Matei2010/CrazyCar_Prototype_-IN_DEVELOPMENT-/BOM (version 1).xlsx

Reference | Value | Datasheet | Footprint | Qty | DISTRIBUTOR | MANUFACTURER | ORDER_NO | PART_NO | Beschreibung | PRICE_UNIT | CATEGORY | Full price (exkl Tax and Shipping) | shipping
BT1 | 8.4V |  |  | 1 | Rotorama | CNHL |  | https://www.rotorama.de/product/cnhl-ministar-hv-450mah-2s-70c | CNHL Ministar HV 450mAh 2S 70C | 5.99 |  | 5.99 | LCSC | "=" | 32.14 |  | (Global standard directline is about 20€ cheaper, but Requires a 50€ tarriffhold which brings it up to about 90€. i dont know if i will get it back, so better to be sure than sorry
BZ1 | Buzzer |  | Buzzer_Beeper:Buzzer_12x9.5RM7.6 | 5 | LCSC | XHXDZ | C49246932 | TMB12A12 | Buzzer, polarized | 0.19 |  | 0.942 | Aliexpress | "=" | 12 € | Free "Choice Shipping" but i have to pay 12€ in tarrifs to austria
C1,C2,C4,C5,C7,C8,C9,C12,C14,C15,C16,C19,C20 | 100n |  | Capacitor_SMD:C_0805_2012Metric | 20 | LCSC | YAGEO | C49678 | CC0805KRX7R9BB104 | Unpolarized capacitor | 0.19 |  | 3.8 | Rotorama | "=" | 5.58
C3 | 470uF |  | Capacitor_THT:CP_Radial_D8.0mm_P3.50mm | 1 | LCSC | KNSCHA | C2831775 | 03EC0575 |  | 0.04 |  | 0.0415
C6 | 10n |  | Capacitor_SMD:C_0805_2012Metric | 100 | LCSC | CCTC | C282728 | TCC0805X7R103K500DT | Unpolarized capacitor | 0.01 |  | 0.61
C11,C13,C17,C18,C21,C22 | 10u |  | Capacitor_SMD:C_0805_2012Metric | 6 | LCSC | muRata | C440198 | GRM21BR61H106KE43L | Unpolarized capacitor | 0.18 |  | 1.092
D1,D2 | LED |  | LED_SMD:LED_0805_2012Metric | 100 | LCSC | XINGLIGHT | C965799 | XL-1608SURC-06 | Light emitting diode | 0.01 |  | 1
IC1,IC2 | RZ7889 | http://www.rz-mic.com/uploadfile/fj/2011122615211.pdf | RZ7889:SOIC127P600X175-8N | 2 | LCSC | MSKSEMI | C22462543 | RZ7889-MS | SOP-8 3A Single-CH DC Motor Driver Circuit | 0.43 |  | 0.8672
J1 | SWD header |  | Connector_PinHeader_2.54mm:PinHeader_1x05_P2.54mm_Vertical | 1 | LCSC | Ckmtw | C124377 | B-2100S40P-A110 | Generic connector, single row, 01x05, script generated | 0.25 |  | 0.2542
J2,J3 | Conn_01x06_Pin |  | Connector_PinHeader_2.54mm:PinHeader_1x06_P2.54mm_Vertical | 2 | LCSC | Ckmtw | C124377 | B-2100S40P-A110 | Generic connector, single row, 01x06, script generated | 0.25 |  | 0.5084
J4,J5,J6,J7,J8 | VL53L0X |  | Connector_PinHeader_2.54mm:PinHeader_1x05_P2.54mm_Vertical | 5 | LCSC | Ckmtw | C124377 | B-2100S40P-A110 | Generic connector, single row, 01x05, script generated | 0.25 |  | 1.271
J9,J11 | Conn_01x02_Socket |  | Connector_AMASS:AMASS_XT30U-F_1x02_P5.0mm_Vertical | 2 | LCSC | AMASS | C99102 | XT30U-F | Generic connector, single row, 01x02, script generated | 0.19 |  | 0.384
J10 | Conn_01x02_Socket |  | Connector_PinHeader_2.54mm:PinHeader_1x02_P2.54mm_Vertical | 1 | LCSC | Ckmtw | C124377 | B-2100S40P-A110 | Generic connector, single row, 01x02, script generated | 0.25 |  | 0.2542
J12 | Conn_01x04_Pin |  | Connector_PinHeader_2.54mm:PinHeader_1x04_P2.54mm_Vertical | 1 | LCSC | Ckmtw | C124377 | B-2100S40P-A110 | Generic connector, single row, 01x04, script generated | 0.25 |  | 0.2542
J13,J14,J15,J16,J17 | sensor |  |  | 5 |  | Sailstart | https://de.aliexpress.com/item/1005007639367196.html?curPageLogUid=bZ3LkQM9F6hp |  | Cheapest Aliexpress Vl53L0x sensors | 2.00 |  | 10
M1,M2 | Motor_DC |  | minimouse:N20_with_encoder | 2 |  |  | https://de.aliexpress.com/item/1005007886406269.html?curPageLogUid=jBtskPUPHgLK |  | DC Motor | 6.85 |  | 13.7
M3 | Brushless mtor |  |  | 1 | Rotorama |  | https://www.rotorama.de/product/happymodel-rs0802-20000kv-2 |  | Happymodel RS0802 20000Kv Brushless mtor | 9.99 |  | 9.99
Q1 | 2N3904 | https://www.onsemi.com/pub/Collateral/2N3903-D.PDF | Package_TO_SOT_THT:TO-92_Inline | 5 | LCSC | onsemi | C124482 | 2N3904BU | 0.2A Ic, 40V Vce, Small Signal NPN Transistor, TO-92 | 0.09 |  | 0.4725
R1,R2,R3,R8,R10,R16,R17,R18 | 10k |  | Resistor_SMD:R_0805_2012Metric | 100 | LCSC | UNI-ROYAL | C17414 | 0805W8F1002T5E | Resistor | 0.0032 |  | 0.32
R4,R5 | 100R |  | Resistor_SMD:R_0805_2012Metric | 100 | LCSC | FOJAN | C2907218 | FRC0805F1000TS | Resistor | 0.0029 |  | 0.29
R6,R7 | 4k7 |  | Resistor_SMD:R_0805_2012Metric | 100 | LCSC | FOJAN | C2907264 | FRC0805F4701TS | Resistor | 0.0026 |  | 0.26
R9 | 33k |  | Resistor_SMD:R_0805_2012Metric | 100 | LCSC | FOJAN | C2933415 | FRC0805F3302TS | Resistor | 0.0028 |  | 0.28
R13,R14 | 330R |  | Resistor_SMD:R_0805_2012Metric | 100 | LCSC | UNI-ROYAL | C17630 | 0805W8F3300T5E | Resistor | 0.0042 |  | 0.42 |  |  |  | FULL PRICE:
R15 | 1k |  | Resistor_SMD:R_0805_2012Metric | 100 | LCSC | YAGEO | C95781 | RC0805FR-071KL | Resistor | 0.0029 |  | 0.29 |  |  |  | 109.11
SW1,SW2 | Push_Button |  | Button_Switch_THT:SW_PUSH_6mm | 10 | LCSC | CAX | C53431127 | TS-6645DD-6x6x5-100 | Common 6mmx6mm Push Button | 0.04 |  | 0.361 |  |  |  | (a 20€ buffer would be nice if allowed for surprise customs and duties or if) something breaks
U1 | STM32C092CCT6 | https://www.st.com/resource/en/datasheet/stm32c092cct6.pdf | Package_QFP:LQFP-48_7x7mm_P0.5mm | 1 | LCSC | ST | C45338511 | STM32C092CCT6 |  | 3.99 |  | 3.99
U2,U3 | TMCS1100A3QDR | https://www.ti.com/lit/gpn/tmcs1100 | TMCS1100A1:SOIC8_D_TEX | 2 | LCSC | TI | C2873352 | TMCS1100A3QDR |  | 2.57 |  | 5.14
U4 | TCA9548APWR | http://www.ti.com/lit/ds/symlink/tca9548a.pdf | Package_SO:TSSOP-24_4.4x7.8mm_P0.65mm | 1 | LCSC | TI | C130026 | TCA9548APWR | Low voltage 8-channel I2C switch with reset, TSSOP-24 | 0.76 |  | 0.7641
U5 | MPU-6500 |  | MPU-6500:QFN40P300X300X95-25N | 1 | LCSC | TDK InvenSense | C50278 | MPU-6500 | MotionTracking Device Digital Output 1.8V 24-Pin QFN EP T/R | 4.95 |  | 4.9483
U6 | TSR1-2433E | https://www.tracopower.com/products/tsr1e.pdf | Converter_DCDC:Converter_DCDC_TRACO_TSR1-xxxxE_THT | 1 | LCSC | YLPTEC | C53183919 | TSR 1-2433 | 1A step-down regulator, fixed 3.3V output voltage, 6-36V input voltage, TO-220 compatible LM78xx replacement | 3.55 |  | 3.55
U7 |  |  |  | 1 | Rotorama | Graupner |  | https://www.rotorama.de/product/graupner-ultra-control-10a-1-2s-blheli-s | Graupner Ultra Control 10A 1-2S BLS | 3.99 |  | 3.99
V1 | 1N4148 | https://diotec.com/request/datasheet/1n4148.pdf | Diode_THT:D_DO-35_SOD27_P7.62mm_Horizontal | 20 | LCSC | onsemi | C258182 | 1N4148 | Kleinsignal Schaltdiode, THT Do-35 (SOD-27), 1N4148, 1N4150, 1N4151, 1N4448 | 0.03 |  | 0.544
 |  |  |  |  |  |  |  |  |  |  |  | 76.5786
