Matei2010/CrazyCar_Prototype_-IN_DEVELOPMENT-/3Dmodels/crazy car full.3mf

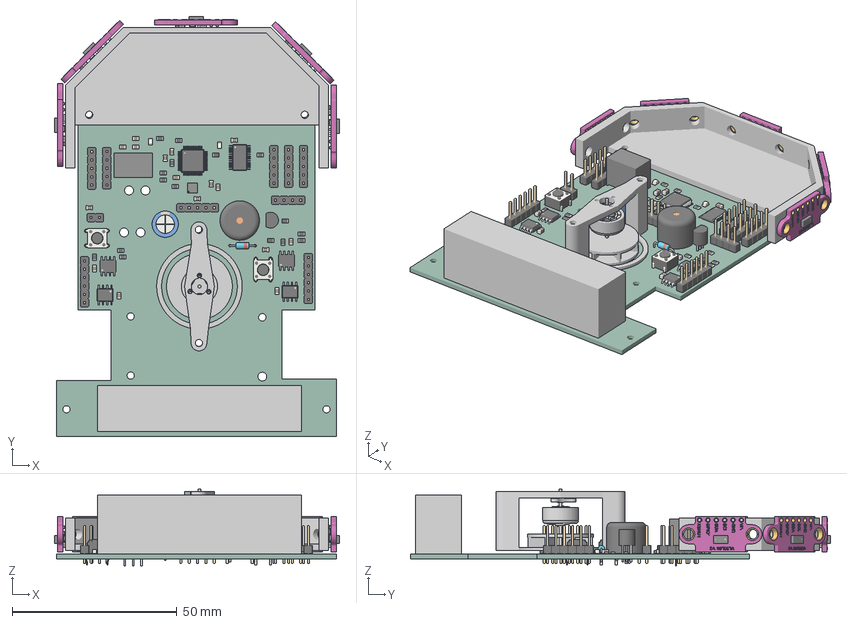
[picture p1: CAD file, 2026-11-09]
3Dmodels/crazy car full.3mf
86.6 x 127.6 x 23.3 mm
Körper1 x 189
Körper10 x 7
Körper11 x 2
Körper12 x 2
Körper13 x 2
Körper14 x 2
Körper15 x 2
Körper16 x 2
Körper17 x 2
Körper18 x 2
Körper19 x 2
Körper2 x 38
Körper20 x 2
Körper21 x 2
Körper22 x 2
Körper23 x 2
Körper24 x 2
Körper25 x 2
Körper26
Körper27
Körper3 x 37
Körper4 x 17
Körper5 x 17
Körper6 x 7
Körper7 x 7
Körper8 x 7
Körper9 x 7
