Matei2010/CrazyCar_Prototype_-IN_DEVELOPMENT-/3Dmodels/Akku.3mf

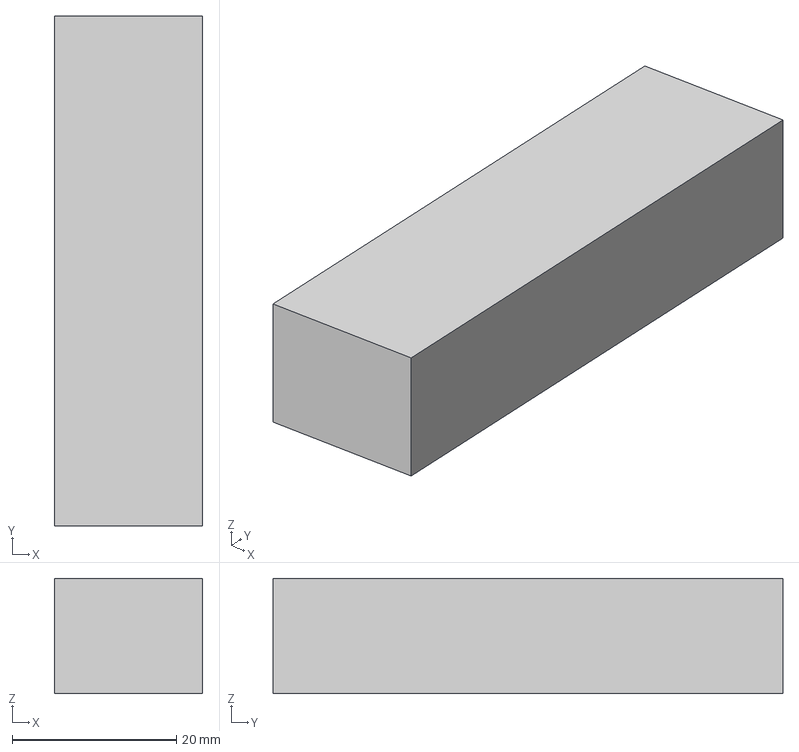
[picture p2: CAD file, 2026-11-09]
3Dmodels/Akku.3mf
18.0 x 62.0 x 14.0 mm
