Matei2010/CrazyCar_Prototype_-IN_DEVELOPMENT-/3Dmodels/impeller halter.3mf

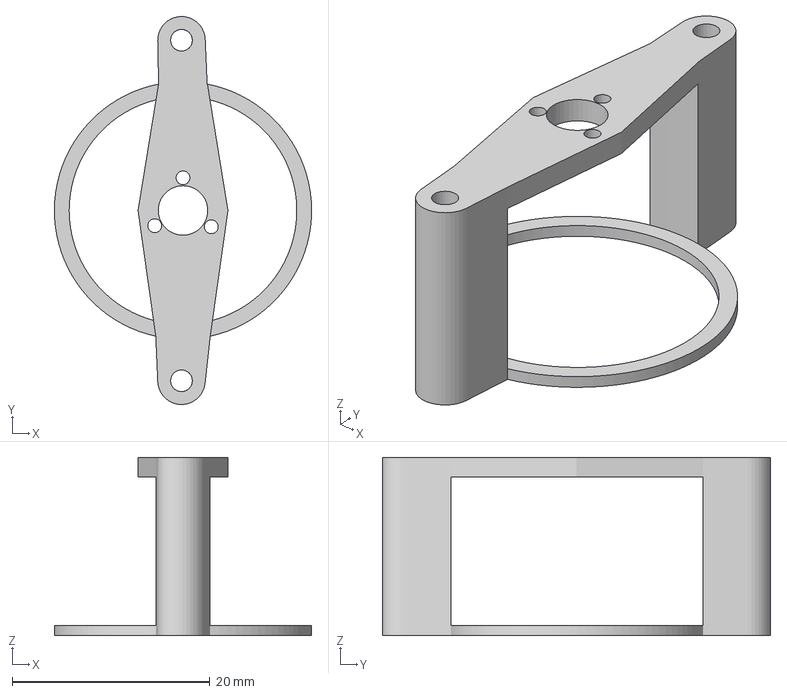
[picture p3: CAD file, 2026-11-09]
3Dmodels/impeller halter.3mf
26.0 x 39.2 x 18.0 mm
