Matei2010/CrazyCar_Prototype_-IN_DEVELOPMENT-/3Dmodels/holdersensor.3mf

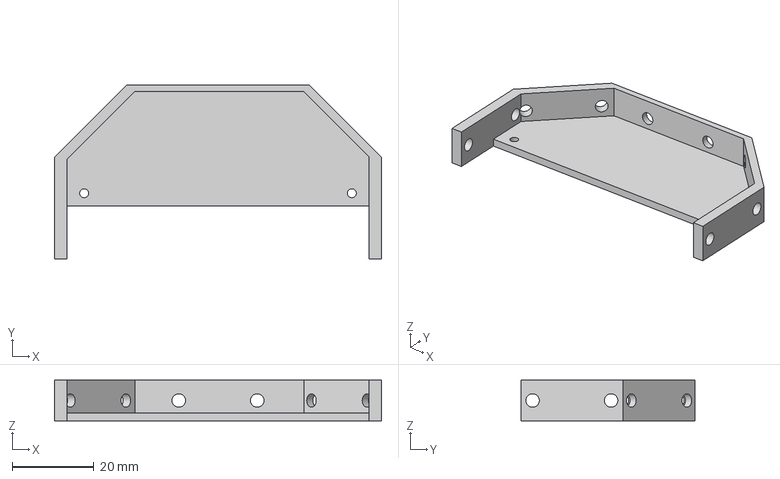
[picture p4: CAD file, 2026-11-09]
3Dmodels/holdersensor.3mf
80.0 x 42.7 x 10.0 mm
