Matei2010/CrazyCar_Prototype_-IN_DEVELOPMENT-/3Dmodels/Bracket.step

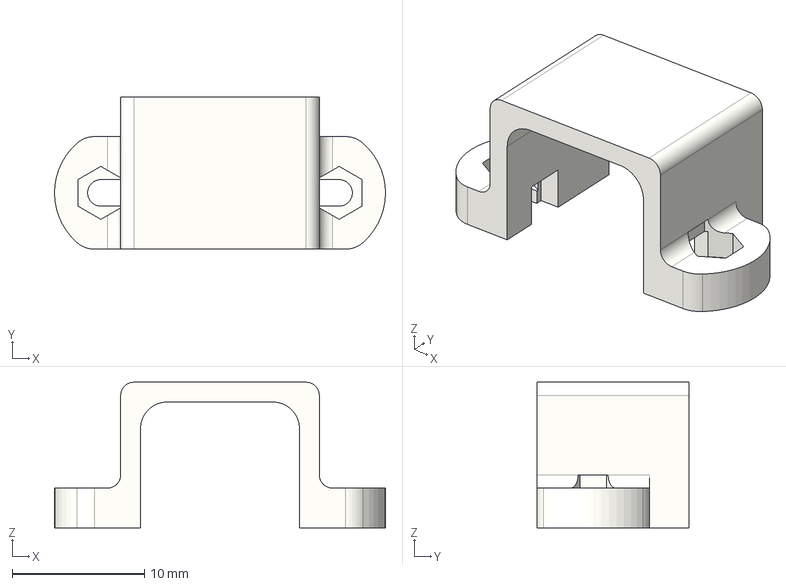
[picture p5: CAD file, 2026-11-09]
3Dmodels/Bracket.step
25.0 x 11.5 x 11.0 mm
