Matei2010/CrazyCar_Prototype_-IN_DEVELOPMENT-/3Dmodels/VL53L0X_TOF.3mf

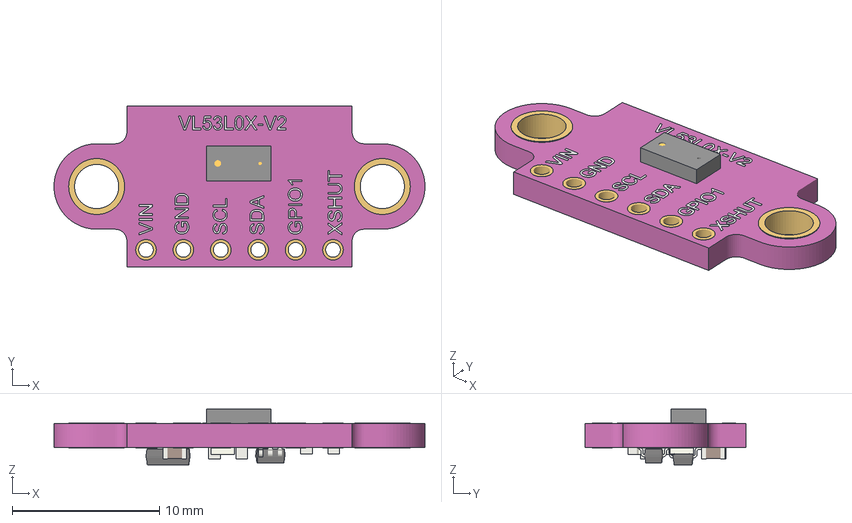
[picture p6: CAD file, 2026-11-09]
3Dmodels/VL53L0X_TOF.3mf
25.2 x 10.9 x 3.80 mm
Körper1 x 25
Körper10
Körper2 x 7
Körper3 x 7
Körper4 x 3
Körper5 x 3
Körper6
Körper7
Körper8
Körper9
