Matei2010/CrazyCar_Prototype_-IN_DEVELOPMENT-/3Dmodels/0802_Brushless_Motor_Model.stl

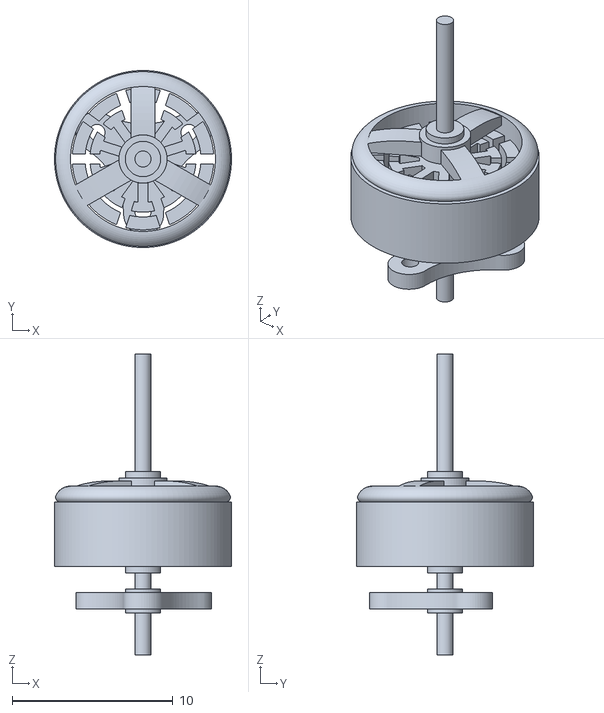
[picture p7: CAD file, 2026-11-09]
3Dmodels/0802_Brushless_Motor_Model.stl
11.0 x 11.0 x 18.7
