Matei2010/CrazyCar_Prototype_-IN_DEVELOPMENT-/3Dmodels/carzycarneueplatine2.step

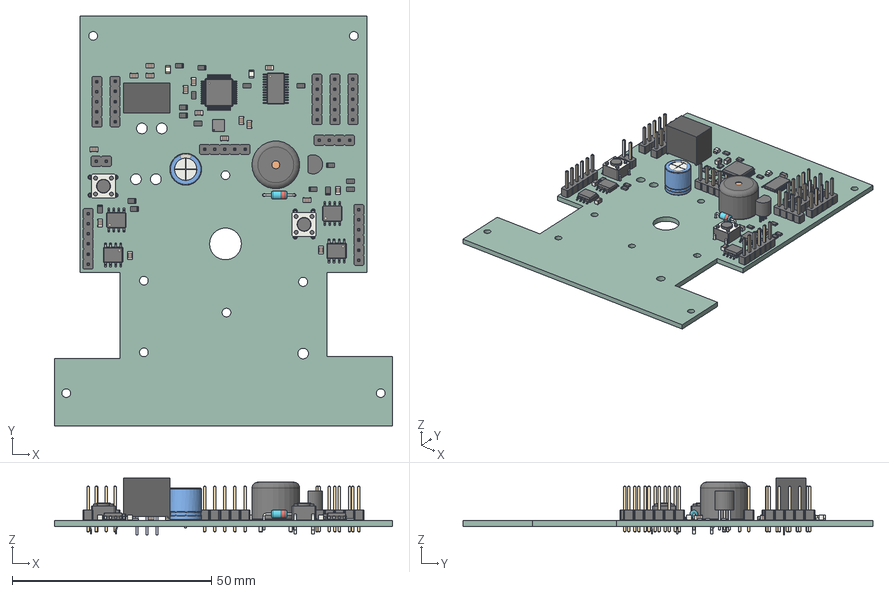
[picture p8: CAD file, 2026-11-09]
3Dmodels/carzycarneueplatine2.step
85.0 x 103.0 x 14.2 mm
PinHeader_1x05_P254mm_Vertical x 6
R_0805_2012Metric x 16
C_0805_2012Metric x 16
PinHeader_1x04_P254mm_Vertical
SOIC-8-1EP_3.9x4.9mm_P1.27mm_EP2.29x3mm x 2
LQFP-48_7x7mm_P0.5mm
D_DO-35_SOD27_P7.62mm_Horizontal
SW_PUSH_6mm x 2
TO-92_Inline_Narrow
Buzzer_12x95RM76
LED_0805_2012Metric x 2
TSR 1
PinHeader_1x06_P254mm_Vertical x 2
PinHeader_1x02_P254mm_Vertical
TSSOP-24_4.4x7.8mm_P0.65mm
SOIC-8_3.9x4.9mm_P1.27mm x 2
CP_Radial_D80mm_P350mm
MPU-6500
car71C7_PCB
