Matei2010/CrazyCar_Prototype_-IN_DEVELOPMENT-/3Dmodels/impellerneuimit ohne test.3mf

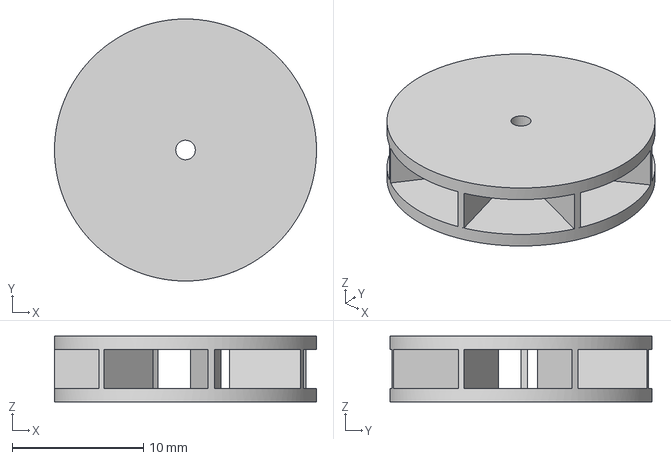
[picture p9: CAD file, 2026-11-09]
3Dmodels/impellerneuimit ohne test.3mf
20.0 x 20.0 x 5.00 mm
