Matei2010/CrazyCar_Prototype_-IN_DEVELOPMENT-/3Dmodels/N20 Mini Micro Metall Gear Motor.step

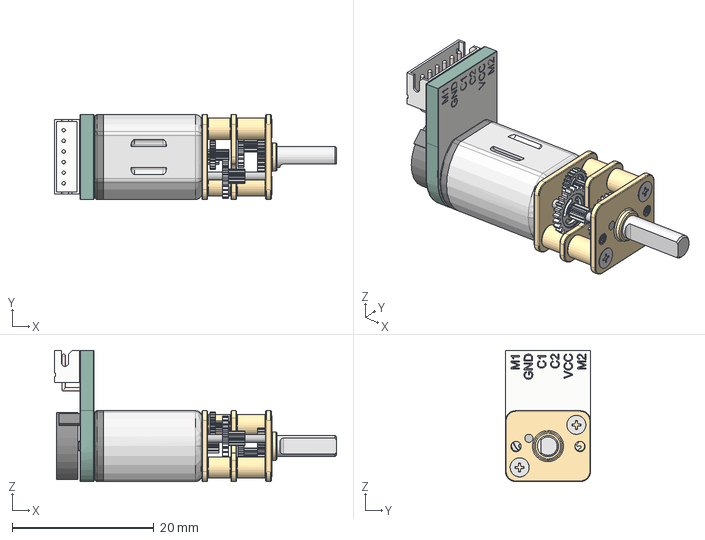
[picture p10: CAD file, 2026-11-09]
3Dmodels/N20 Mini Micro Metall Gear Motor.step
39.8 x 12.0 x 18.5 mm
