Matei2010/CrazyCar_Prototype_-IN_DEVELOPMENT-/carzycar.kicad_pcb

## KiCad design carzycar.kicad_pcb (2026-11-14)

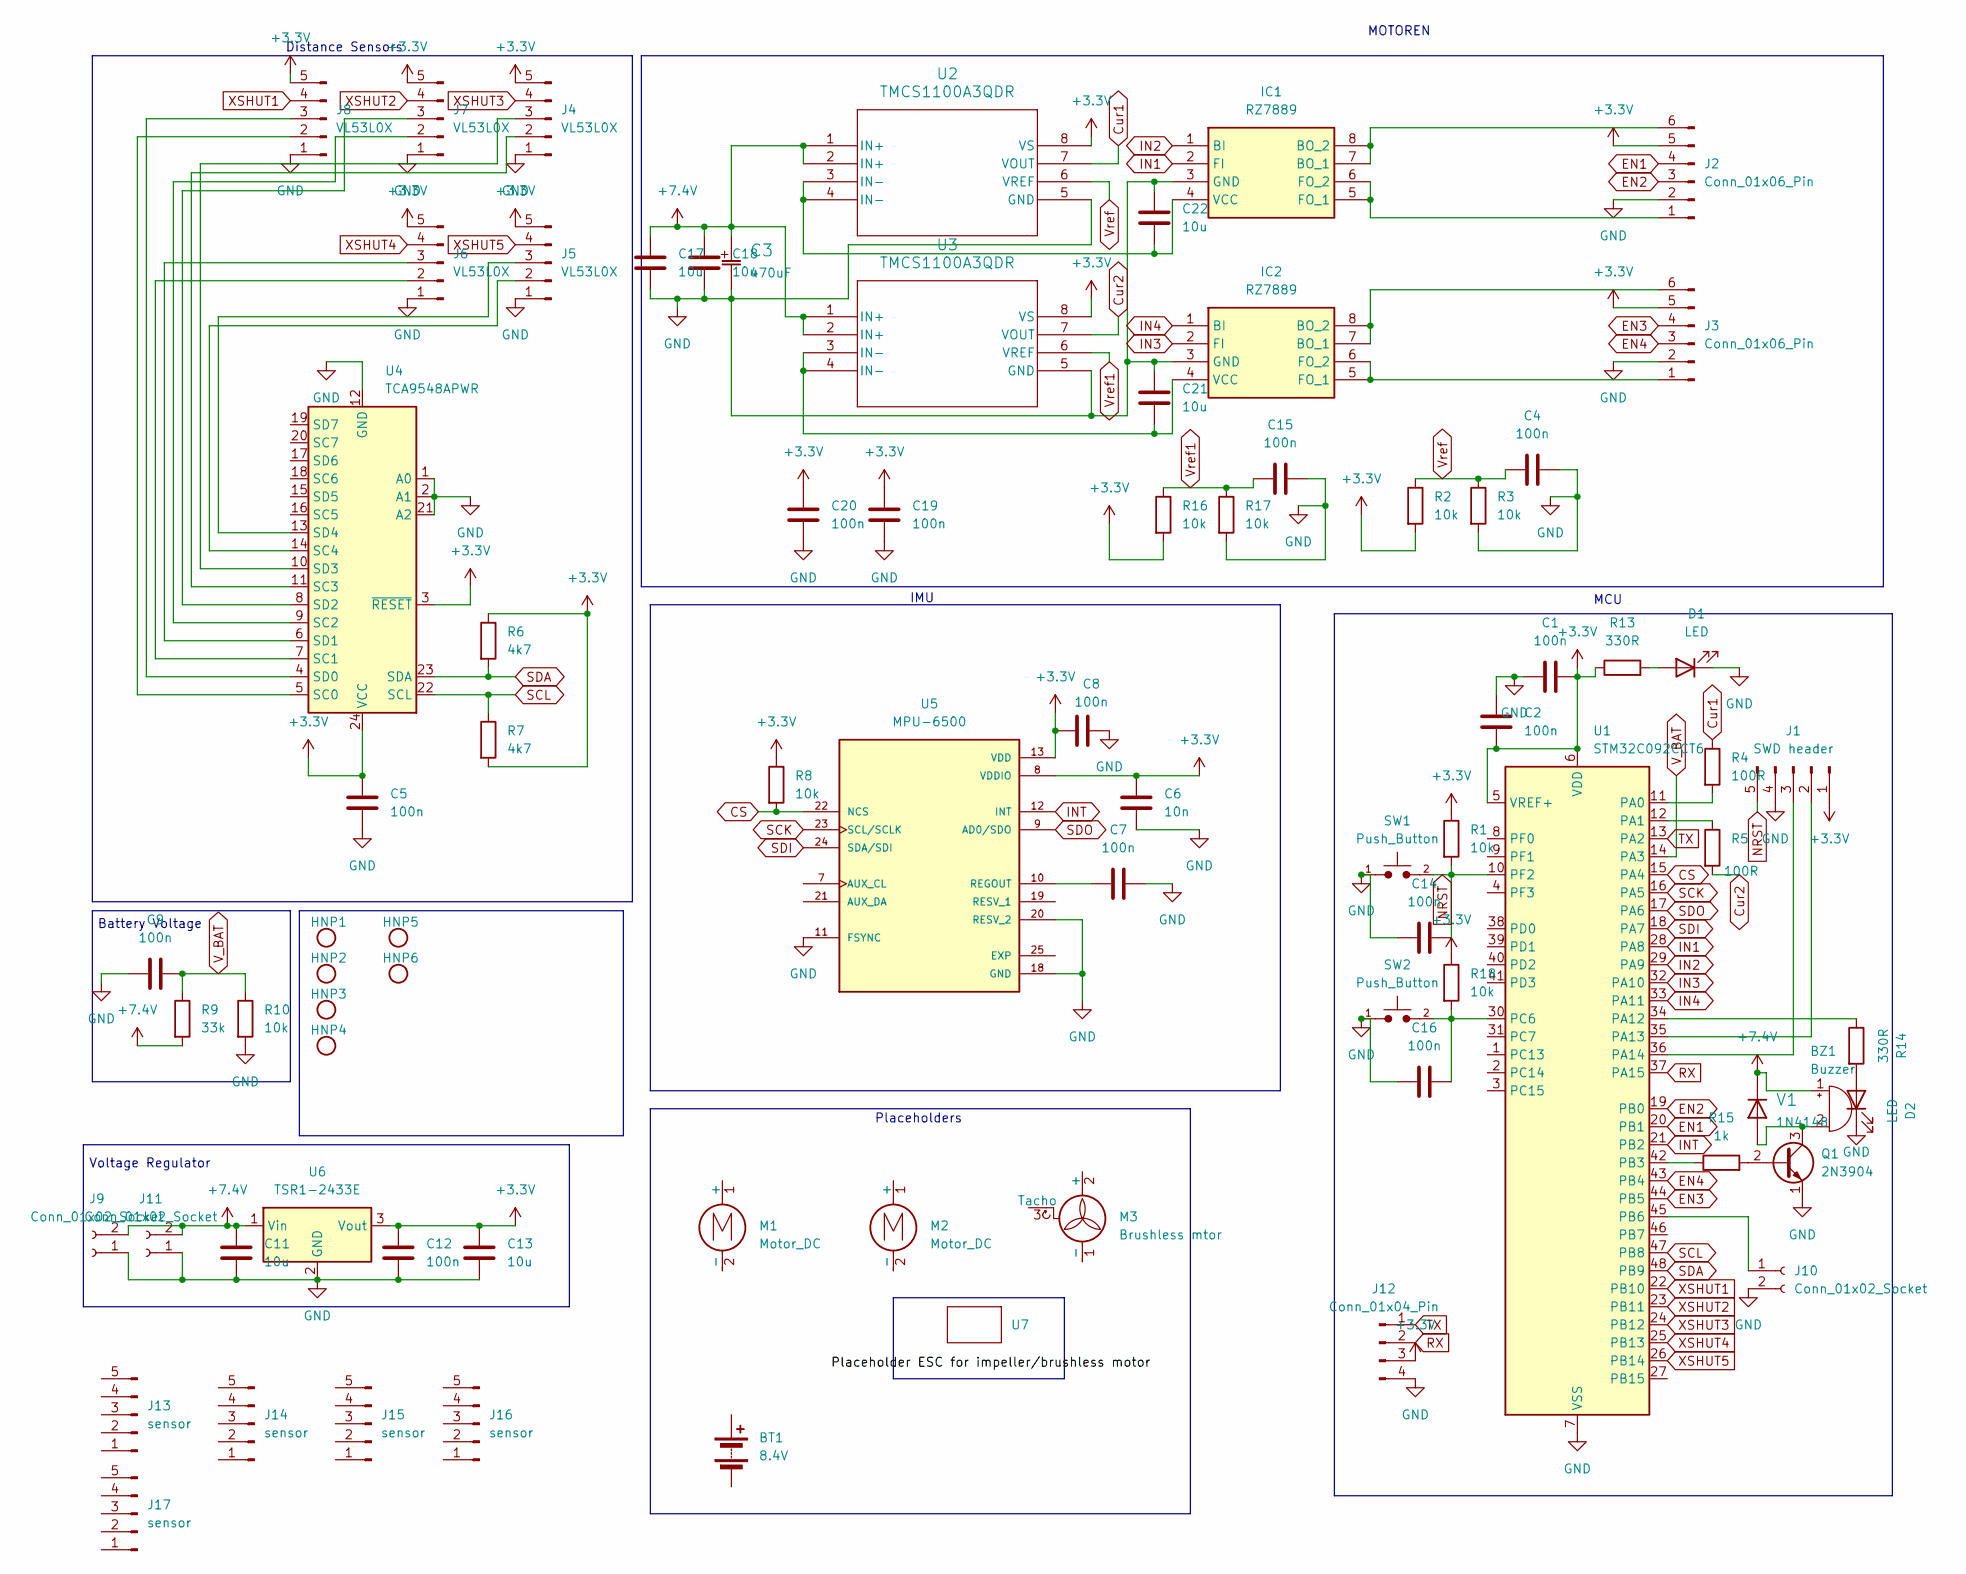
[picture p11: schematic carzycar.kicad_sch, Benennung/Projekt]

Parts:
BT1: 8.4V
BZ1: Buzzer; Buzzer_12x9.5RM7.6; PART_NO TMB12A12
C1, C2, C4, C5, C7, C8, C9, C12, C14, C15, C16, C19, C20: 100n; C_0805_2012Metric; PART_NO CC0805KRX7R9BB104
C3: 470uF; CP_Radial_D8.0mm_P3.50mm; PART_NO 03EC0575
C6: 10n; C_0805_2012Metric; PART_NO TCC0805X7R103K500DT
C11, C13, C17, C18, C21, C22: 10u; C_0805_2012Metric; PART_NO GRM21BR61H106KE43L
D1, D2: LED; LED_0805_2012Metric; PART_NO XL-1608SURC-06
HNP1, HNP2, HNP3, HNP4, HNP5, HNP6: NPH; MountingHole_2.2mm_M2
IC1, IC2: RZ7889; SOIC127P600X175-8N; Manufacturer_Part_Number RZ7889
J1: SWD header; PinHeader_1x05_P2.54mm_Vertical; PART_NO B-2100S40P-A110
J2, J3: Conn_01x06_Pin; PinHeader_1x06_P2.54mm_Vertical; PART_NO B-2100S40P-A110
J4, J5, J6, J7, J8: VL53L0X; PinHeader_1x05_P2.54mm_Vertical; PART_NO B-2100S40P-A110
J9, J11: Conn_01x02_Socket; AMASS_XT30U-F_1x02_P5.0mm_Vertical; PART_NO XT30U-F
J10: Conn_01x02_Socket; PinHeader_1x02_P2.54mm_Vertical; PART_NO B-2100S40P-A110
J12: Conn_01x04_Pin; PinHeader_1x04_P2.54mm_Vertical; PART_NO B-2100S40P-A110
J13, J14, J15, J16, J17: sensor
M1, M2: Motor_DC; N20_with_encoder
M3: Brushless mtor
Q1: 2N3904; TO-92_Inline; PART_NO 2N3904BU
R1, R2, R3, R8, R10, R16, R17, R18: 10k; R_0805_2012Metric; PART_NO 0805W8F1002T5E
R4, R5: 100R; R_0805_2012Metric; PART_NO FRC0805F1000TS
R6, R7: 4k7; R_0805_2012Metric; PART_NO FRC0805F4701TS
R9: 33k; R_0805_2012Metric; PART_NO FRC0805F3302TS
R13, R14: 330R; R_0805_2012Metric; PART_NO 0805W8F3300T5E
R15: 1k; R_0805_2012Metric; PART_NO RC0805FR-071KL
SW1, SW2: Push_Button; SW_PUSH_6mm; PART_NO TS-6645DD-6x6x5-100
U1: STM32C092CCT6; LQFP-48_7x7mm_P0.5mm; PART_NO STM32C092CCT6
U2, U3: TMCS1100A3QDR; SOIC8_D_TEX; PART_NO TMCS1100A3QDR
U4: TCA9548APWR; TSSOP-24_4.4x7.8mm_P0.65mm; PART_NO TCA9548APWR
U5: MPU-6500; QFN40P300X300X95-25N; PARTREV 1.3
U6: TSR1-2433E; Converter_DCDC_TRACO_TSR1-xxxxE_THT; PART_NO TSR 1-2433
U7: (no value)
V1: 1N4148; D_DO-35_SOD27_P7.62mm_Horizontal; PART_NO 1N4148

Connections:
+3.3V: C1.2, C2.1, C5.1, C6.1, C8.1, C12.1, C13.1, C19.1, C20.1, J1.1, J2.5, J3.5, J4.5, J5.5, J6.5, J7.5, J8.5, J12.3, R1.1, R2.2, R6.1, R7.2, R8.1, R13.1, R16.2, R18.1, U1.5 (VREF+), U1.6 (VDD), U2.8 (VS), U3.8 (VS), U4.3 (~RESET), U4.24 (VCC), U5.8 (VDDIO), U5.13 (VDD), U6.3 (Vout)
+7.4V: BZ1.1 (+), C3.1 (+), C11.1, C17.1, C18.1, J9.2, J11.2, R9.2, U2.1 (IN+), U2.2 (IN+), U3.1 (IN+), U3.2 (IN+), U6.1 (Vin), V1.1 (C)
CS: R8.2, U1.15 (PA4), U5.22 (NCS)
Cur1: R4.1, U2.7 (VOUT)
Cur2: R5.2, U3.7 (VOUT)
EN1: J2.4, U1.20 (PB1)
EN2: J2.3, U1.19 (PB0)
EN3: J3.4, U1.44 (PB5)
EN4: J3.3, U1.43 (PB4)
GND: C1.1, C2.2, C3.2 (-), C4.2, C5.2, C6.2, C7.2, C8.2, C9.1, C11.2, C12.2, C13.2, C14.1, C15.2, C16.1, C17.2, C18.2, C19.2, C20.2, C21.1, C22.1, D1.1 (K), D2.1 (K), IC1.3 (GND), IC2.3 (GND), J1.4, J2.2, J3.2, J4.1, J5.1, J6.1, J7.1, J8.1, J9.1, J10.2, J11.1, J12.4, Q1.1 (E), R3.2, R10.2, R17.2, SW1.1, SW2.1, U1.7 (VSS), U2.5 (GND), U3.5 (GND), U4.1 (A0), U4.2 (A1), U4.12 (GND), U4.21 (A2), U5.11 (FSYNC), U5.18 (GND), U5.20 (RESV_2), U6.2 (GND)
IN1: IC1.2 (FI), U1.28 (PA8)
IN2: IC1.1 (BI), U1.29 (PA9)
IN3: IC2.2 (FI), U1.32 (PA10)
IN4: IC2.1 (BI), U1.33 (PA11)
INT: U1.21 (PB2), U5.12 (INT)
NRST: C14.2, J1.5, R1.2, SW1.2, U1.10 (PF2)
unnamed: BZ1.2 (-), Q1.3 (C), V1.2 (A)
unnamed: D1.2 (A), R13.2
unnamed: D2.2 (A), R14.2
unnamed: IC1.7 (BO_1), IC1.8 (BO_2), J2.6
unnamed: IC1.5 (FO_1), IC1.6 (FO_2), J2.1
unnamed: C22.2, IC1.4 (VCC), U2.3 (IN-), U2.4 (IN-)
unnamed: IC2.7 (BO_1), IC2.8 (BO_2), J3.6
unnamed: IC2.5 (FO_1), IC2.6 (FO_2), J3.1
unnamed: C21.2, IC2.4 (VCC), U3.3 (IN-), U3.4 (IN-)
unnamed: J1.2, U1.35 (PA13)
unnamed: J1.3, U1.36 (PA14)
unnamed: J4.2, U4.11 (SC3)
unnamed: J4.3, U4.10 (SD3)
unnamed: J5.2, U4.14 (SC4)
unnamed: J5.3, U4.13 (SD4)
unnamed: J6.2, U4.7 (SC1)
unnamed: J6.3, U4.6 (SD1)
unnamed: J7.2, U4.9 (SC2)
unnamed: J7.3, U4.8 (SD2)
unnamed: J8.2, U4.5 (SC0)
unnamed: J8.3, U4.4 (SD0)
unnamed: J10.1, U1.45 (PB6)
unnamed: Q1.2 (B), R15.2
unnamed: R4.2, U1.11 (PA0)
unnamed: R5.1, U1.12 (PA1)
unnamed: R14.1, U1.34 (PA12)
unnamed: R15.1, U1.42 (PB3)
unnamed: C16.2, R18.2, SW2.2, U1.30 (PC6)
unnamed: C7.1, U5.10 (REGOUT)
RX: J12.2, U1.37 (PA15)
SCK: U1.16 (PA5), U5.23 (SCL/SCLK)
SCL: R7.1, U1.47 (PB8), U4.22 (SCL)
SDA: R6.2, U1.48 (PB9), U4.23 (SDA)
SDI: U1.18 (PA7), U5.24 (SDA/SDI)
SDO: U1.17 (PA6), U5.9 (AD0/SDO)
TX: J12.1, U1.13 (PA2)
V_BAT: C9.2, R9.1, R10.1, U1.14 (PA3)
Vref: C4.1, R2.1, R3.1, U2.6 (VREF)
Vref1: C15.1, R16.1, R17.1, U3.6 (VREF)
XSHUT1: J8.4, U1.22 (PB10)
XSHUT2: J7.4, U1.23 (PB11)
XSHUT3: J4.4, U1.24 (PB12)
XSHUT4: J6.4, U1.25 (PB13)
XSHUT5: J5.4, U1.26 (PB14)

Notes on the sheet:
Distance Sensors
Battery Voltage
Voltage Regulator
MOTOREN
Placeholders
IMU
MCU

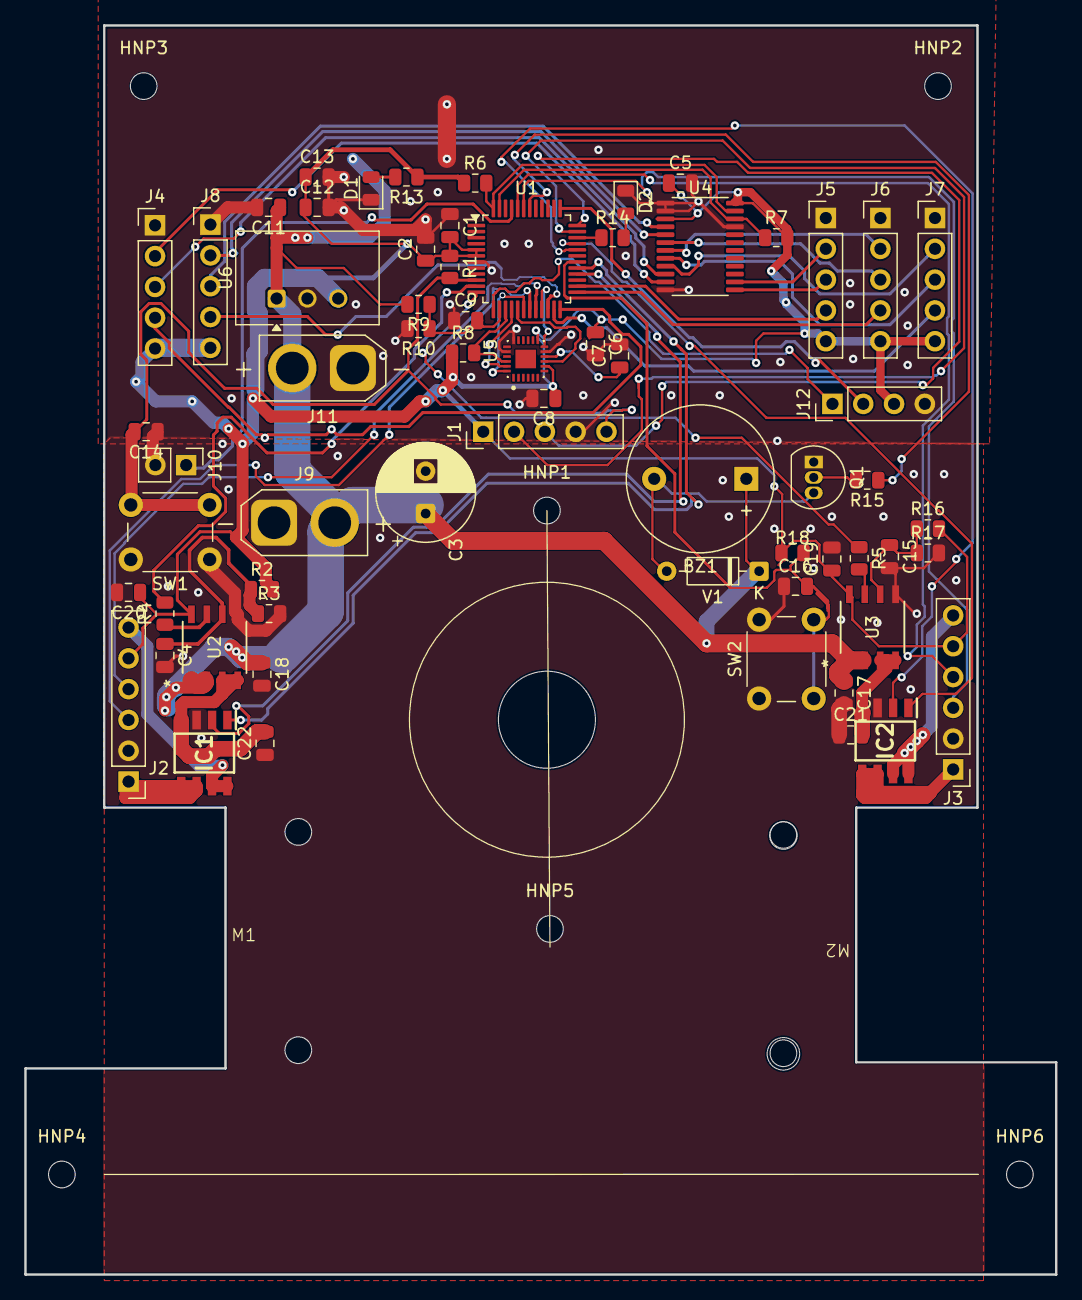
[picture p12: board carzycar.kicad_pcb from above]

Board: 2 copper layers, 85.0 x 103.0 mm, 72 parts (0 on the bottom side), 60 nets.
