Matei2010/CrazyCar_Prototype_-IN_DEVELOPMENT-/(commit log)

2026-10-24 First few placements
    Not done:
    ADDED THINGS:
    MCU
    H-bridges with current-sensing
    Beginning of sensor pins
    [carzycar.kicad_pcb, carzycar.kicad_sch]
2026-10-29 update only layout missing
    [carzycar.kicad_pcb, carzycar.kicad_sch]
2026-10-29 Create BOM.csv with component details
    Added Bill of Materials (BOM) with components and specifications.
    [BOM.csv]
2026-10-31 Update BOM.csv with new component detail
    Removed obsolete components and updated quantities in BOM.
    [BOM.csv]
2026-11-01 Revise sensor integration notes and project status
    Updated integration considerations and project status in README.
2026-11-02 updated project files
    [carzycar.kicad_pcb, carzycar.kicad_sch]
2026-11-02 uploaded updated BOM
    [carzycarBOM.csv]
2026-11-09 Add new kicad files
    [carzycar.kicad_pcb, carzycar.kicad_sch]
2026-11-09 Enhance README with project details and images
    Updated project description, added images, and clarified PCB design details.
2026-11-14 Update KiCad schematic, PCB layout, Gerbers, and BOM
    [BOM (version 1).xlsx, BOM.csv, carzycar.kicad_pcb, carzycar.kicad_sch, final_bom.csv, final_designators.csv, final_positions.csv]
